attaloslife/ThermoLoop/v1.0/Enclosure/Base.SLDPRT

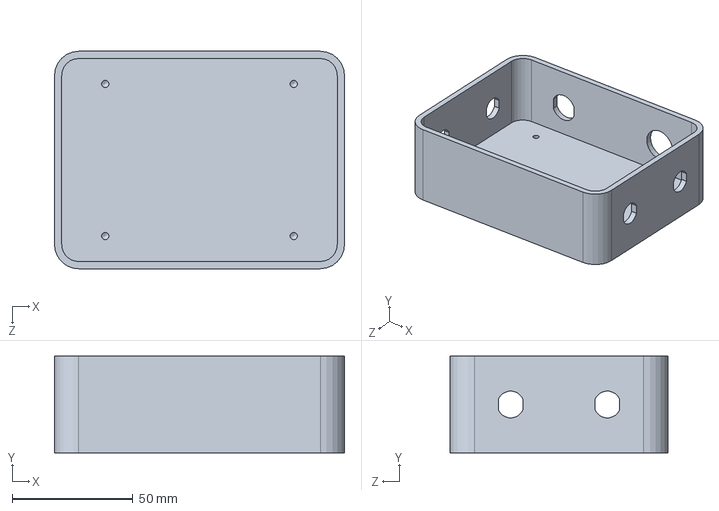
[picture p1: CAD file, 2026-09-18]
v1.0/Enclosure/Base.SLDPRT
120.0 x 40.0 x 90.0 mm
