attaloslife/ThermoLoop/v1.0/Enclosure/Tensility 54-00293 3-Pin Connector.SLDASM

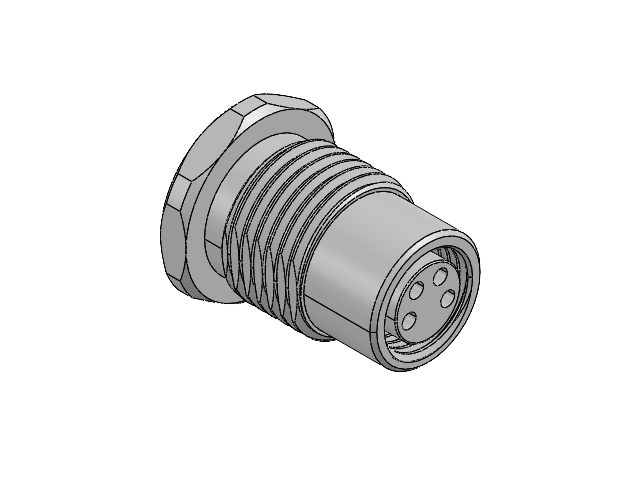
[picture p2: CAD file, 2026-09-18]
v1.0/Enclosure/Tensility 54-00293 3-Pin Connector.SLDASM
54-00293-01___.STEP
54-00293-02___.STEP
54-00293-03___.STEP x 4
54-00293-06___.STEP
