attaloslife/ThermoLoop/v1.0/Simulation/results/pwm.csv

time_s | gpio_V | fan_pwm_V | reset_pwm_V
0.0 | 0.0 | 4.999999999999557 | 4.999999999999556
5e-10 | 0.0 | 4.999999999999556 | 4.999999999999556
1e-09 | 0.0 | 4.999999999999555 | 4.999999999999556
2e-09 | 0.0 | 4.999999999999554 | 4.999999999999556
4e-09 | 0.0 | 4.999999999999554 | 4.999999999999556
8e-09 | 0.0 | 4.999999999999555 | 4.999999999999556
1.6e-08 | 0.0 | 4.999999999999556 | 4.999999999999555
3.2e-08 | 0.0 | 4.999999999999554 | 4.999999999999553
6.4e-08 | 0.0 | 4.999999999999556 | 4.999999999999555
1.1400000000000001e-07 | 0.0 | 4.999999999999555 | 4.999999999999557
1.64e-07 | 0.0 | 4.999999999999554 | 4.999999999999556
2.14e-07 | 0.0 | 4.999999999999553 | 4.999999999999556
2.6400000000000003e-07 | 0.0 | 4.999999999999553 | 4.999999999999556
3.1400000000000003e-07 | 0.0 | 4.999999999999554 | 4.999999999999556
3.6400000000000003e-07 | 0.0 | 4.999999999999555 | 4.999999999999556
4.1400000000000003e-07 | 0.0 | 4.999999999999555 | 4.999999999999556
4.64e-07 | 0.0 | 4.999999999999554 | 4.999999999999556
5.140000000000001e-07 | 0.0 | 4.999999999999553 | 4.999999999999556
5.640000000000001e-07 | 0.0 | 4.999999999999553 | 4.999999999999556
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
