attaloslife/ThermoLoop/v1.0/Simulation/results/startup_0s.csv

time_s | fan_supply_V | source_A
0.0 | 11.975 | 0.05000000000000071
1e-05 | 11.974999999999998 | 0.05000000000000426
2e-05 | 11.974999999999998 | 0.05000000000000426
4e-05 | 11.975000000000001 | 0.04999999999999716
8e-05 | 11.975000000000003 | 0.049999999999993605
0.00016 | 11.975000000000003 | 0.049999999999993605
0.00032 | 11.975000000000001 | 0.04999999999999716
0.00064 | 11.975000000000001 | 0.04999999999999716
0.00128 | 11.975 | 0.05000000000000071
0.00228 | 11.974999999999998 | 0.05000000000000426
0.00328 | 11.975 | 0.05000000000000071
0.00428 | 11.975 | 0.05000000000000071
0.00528 | 11.975 | 0.05000000000000071
0.00628 | 11.975 | 0.05000000000000071
0.00728 | 11.975 | 0.05000000000000071
0.00828 | 11.975 | 0.05000000000000071
0.00928 | 11.975 | 0.05000000000000071
0.010280000000000001 | 11.975 | 0.05000000000000071
0.011280000000000002 | 11.975 | 0.05000000000000071
0.012280000000000003 | 11.975 | 0.05000000000000071
0.013280000000000004 | 11.975 | 0.05000000000000071
0.014280000000000004 | 11.975 | 0.05000000000000071
0.015280000000000005 | 11.975 | 0.05000000000000071
0.016280000000000006 | 11.975 | 0.05000000000000071
0.017280000000000007 | 11.975 | 0.05000000000000071
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
