attaloslife/ThermoLoop/v1.0/Simulation/results/supply_matrix.csv

source_V | lumped_path_ohm | assumed_limit_A | assumed_fan_start_A | assumed_aux_A | fans | stagger_s | peak_demand_A | running_A | peak_bus_V_if_not_limited | steady_bus_V | optimistic_100uF_hold_up_to_10_8V_s | classification
11.4 | 0.1 | 2.0 | 0.55 | 0.05 | 1 | 0 | 0.6000000000000001 | 0.6000000000000001 | 11.34 | 11.34 |  | within_provisional_envelope
11.4 | 0.1 | 2.0 | 0.55 | 0.05 | 1 | 5 | 0.6000000000000001 | 0.6000000000000001 | 11.34 | 11.34 |  | within_provisional_envelope
11.4 | 0.1 | 2.0 | 0.55 | 0.05 | 2 | 0 | 1.1500000000000001 | 1.1500000000000001 | 11.285 | 11.285 |  | within_provisional_envelope
11.4 | 0.1 | 2.0 | 0.55 | 0.05 | 2 | 5 | 1.1500000000000001 | 1.1500000000000001 | 11.285 | 11.285 |  | within_provisional_envelope
11.4 | 0.1 | 2.0 | 0.55 | 0.1 | 1 | 0 | 0.65 | 0.65 | 11.335 | 11.335 |  | within_provisional_envelope
11.4 | 0.1 | 2.0 | 0.55 | 0.1 | 1 | 5 | 0.65 | 0.65 | 11.335 | 11.335 |  | within_provisional_envelope
11.4 | 0.1 | 2.0 | 0.55 | 0.1 | 2 | 0 | 1.2000000000000002 | 1.2000000000000002 | 11.280000000000001 | 11.280000000000001 |  | within_provisional_envelope
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
