attaloslife/ThermoLoop/v1.0/Simulation/results/temperature_accuracy.csv

true_bead_C | modeled_error_min_C | modeled_error_max_C | half_LSB_error_max_C | self_heating_estimate_C | source_impedance_ohm | filter_tau_ms | filter_settle_half_LSB_ms | R25_positive_parameter_error_C | beta_positive_parameter_error_C | pullup_positive_parameter_error_C | ADC_2LSB_positive_parameter_error_C
25 | -0.7686138532935161 | 0.7725972775466516 | 0.05060239693636959 | 0.34031249999999996 | 6000.0 | 0.6 | 4.5741851679069425 | -0.2572796783703666 | 0.0 | 0.25772446970808005 | -0.20223893290693695
26 | -0.8236413026633613 | 0.8284664213385327 | 0.05096229269582864 | 0.3401863415334985 | 5903.730380721314 | 0.5903730380721314 | 4.500792657136174 | -0.2590076635256082 | 0.05017611539750533 | 0.2594569454057023 | -0.20365749627097784
27 | -0.8791698141869801 | 0.8849200807811712 | 0.051361155791994406 | 0.33981159123821086 | 5808.172720443777 | 0.5808172720443776 | 4.4279429184159405 | -0.26074142714259096 | 0.10070457976848957 | 0.261195229687587 | -0.20523146370760514
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
