attaloslife/ThermoLoop/v1.0/Simulation/results/Fan_PWM.cir

.title ThermoLoop Fan_PWM
.include "spice/pwm.inc"
.tran 50n 200u
.end
