attaloslife/ThermoLoop/v1.0/Simulation/results/Startup.cir

.title ThermoLoop Startup
.include "spice/startup.inc"
.tran 1m 7 0 1m
.end
