attaloslife/ThermoLoop/v1.0/Simulation/results/Thermistors.cir

.title ThermoLoop Thermistors
.include "spice/thermistors.inc"
.dc Vtemperature 0 90 1
.end
