attaloslife/ThermoLoop/v1.0/1 Fan 2 Th/_restore_backup_2026-09-18T16-37-54-304/1 Fan 2 Th.kicad_pcb

## KiCad design v1.0/1 Fan 2 Th/_restore_backup_2026-09-18T16-37-54-304/1 Fan 2 Th.kicad_pcb (2026-09-15)

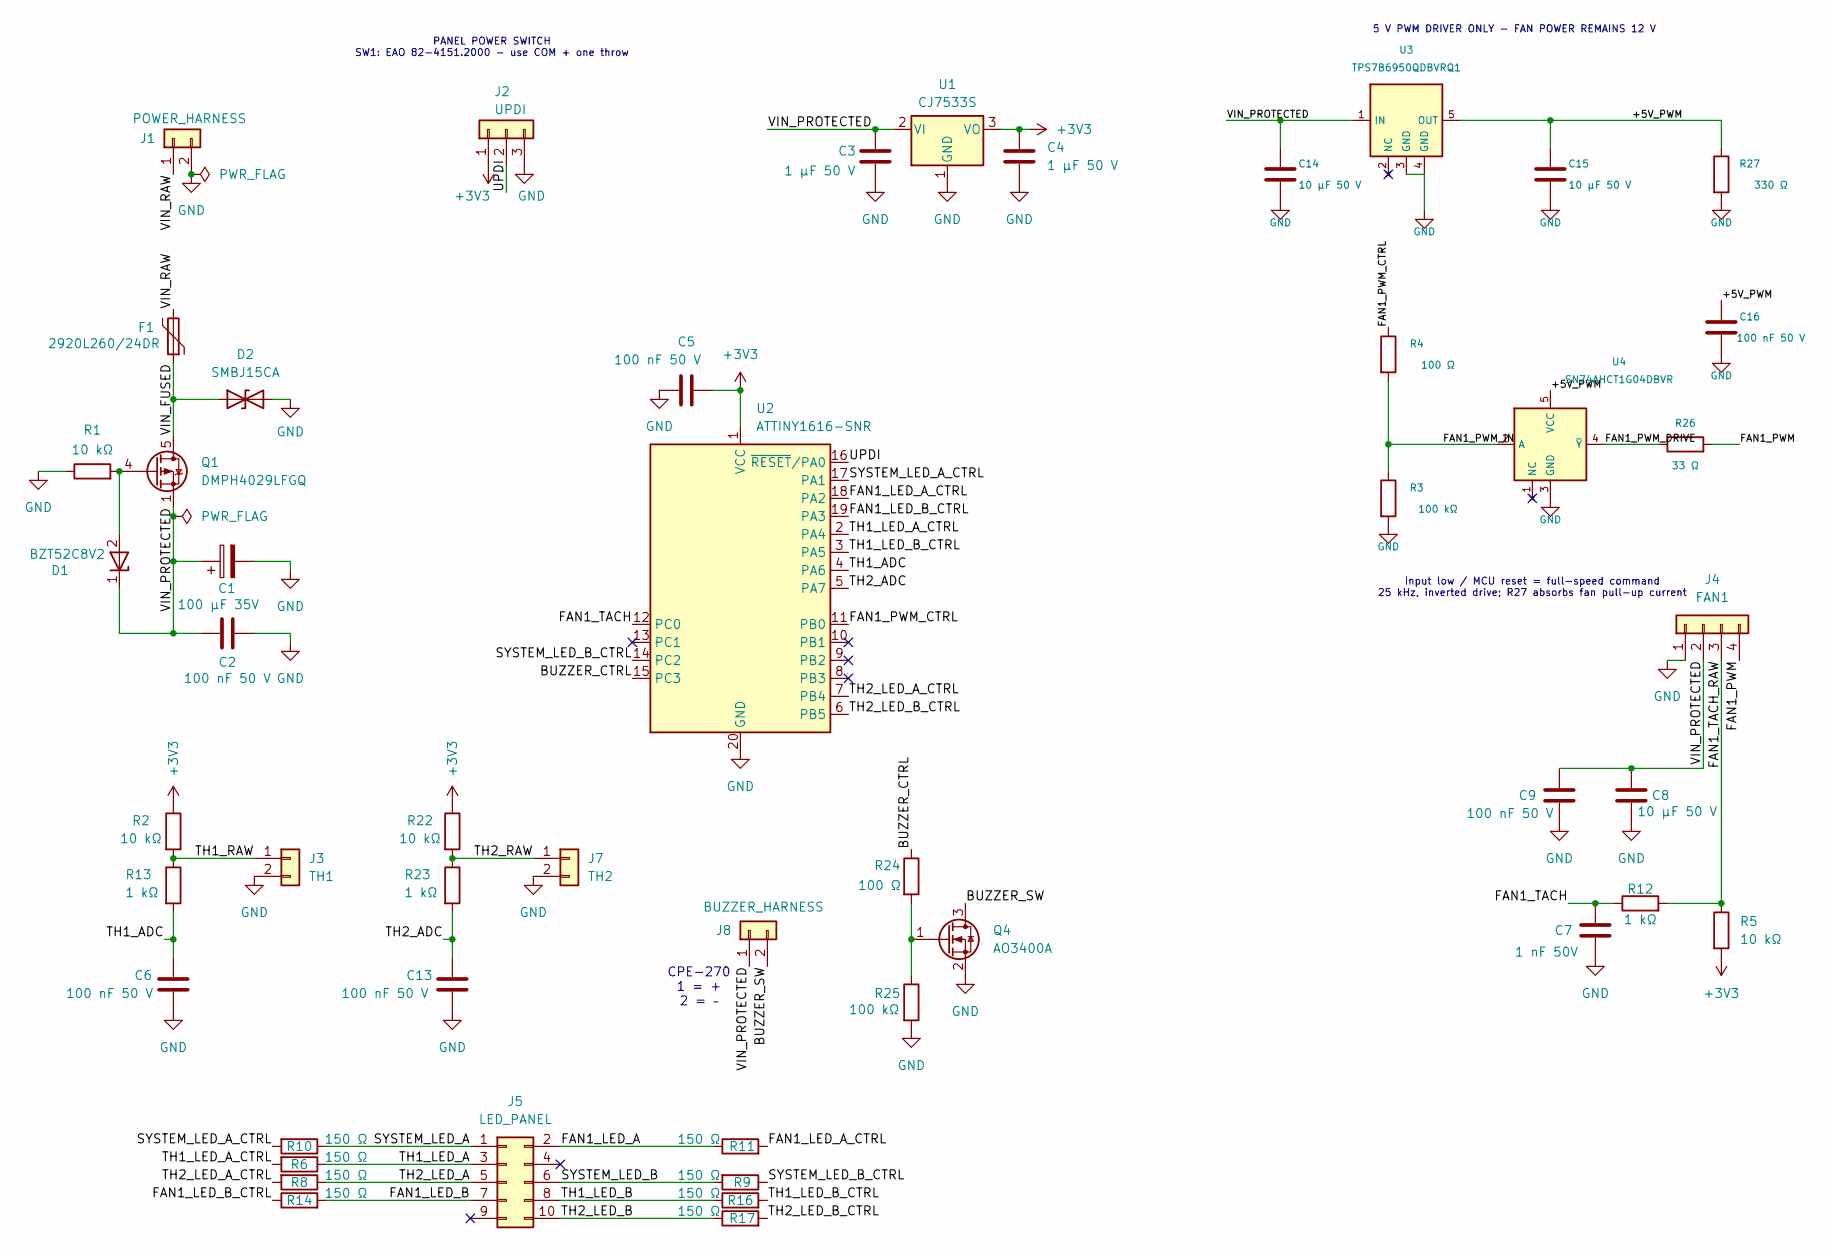
[picture p3: schematic 1 Fan 2 Th.kicad_sch]

Parts:
C1: 100 µF 35V; CP_Elec_6.3x7.7; MPN VZH101M1VTR-0607; JLCPCB C176683
C2, C5, C6, C9, C13, C16: 100 nF 50 V; C_0805_2012Metric; Tolerance ±10%; MPN CC0805KRX7R9BB104; JLCPCB C49678
C3, C4: 1 µF 50 V; C_0805_2012Metric; Tolerance ±10%; MPN CL21B105KBFNNNE; JLCPCB C28323
C7: 1 nF 50V; C_0805_2012Metric; Tolerance ±10%; MPN CL21B102KBCNNNC; JLCPCB C46653
C8, C14, C15: 10 µF 50 V; C_1210_3225Metric; MPN CL32B106KBJNNNE; JLCPCB C138687
D1: BZT52C8V2; D_SOD-123; MPN BZT52C8V2; JLCPCB C173432
D2: SMBJ15CA; D_SMB; MPN SMBJ15CA; JLCPCB C78809
F1: 2920L260/24DR; Fuse_2920_7451Metric; MPN 2920L260/24DR; JLCPCB C315904
J1: POWER_HARNESS; Molex_Micro-Fit_3.0_43045-0218_2x01-1MP_P3.00mm_Vertical; MPN 43045-0218; JLCPCB C476811
J2: UPDI; PinHeader_1x03_P2.54mm_Vertical; MPN 2.54-1*3PPin; JLCPCB C49257
J3: TH1; Molex_Micro-Fit_3.0_43045-0218_2x01-1MP_P3.00mm_Vertical; MPN 43045-0218; JLCPCB C476811
J4: FAN1; Molex_Micro-Fit_3.0_43045-0418_2x02-1MP_P3.00mm_Vertical; MPN 43045-0418; JLCPCB C293535
J5: LED_PANEL; Molex_Micro-Fit_3.0_43045-1018_2x05-1MP_P3.00mm_Vertical; MPN 43045-1018; JLCPCB C476814
J7: TH2; Molex_Micro-Fit_3.0_43045-0218_2x01-1MP_P3.00mm_Vertical; MPN 43045-0218; JLCPCB C476811
J8: BUZZER_HARNESS; Molex_Micro-Fit_3.0_43045-0218_2x01-1MP_P3.00mm_Vertical; MPN 43045-0218; JLCPCB C476811
Q1: DMPH4029LFGQ; Diodes_PowerDI3333-8; MPN DMPH4029LFGQ-7; JLCPCB C3279395
Q4: AO3400A; SOT-23; MPN AO3400A; JLCPCB C20917
R1, R2, R5, R22: 10 kΩ; R_0603_1608Metric; Tolerance ±1%; MPN 0603WAF1002T5E; JLCPCB C25804
R3, R25: 100 kΩ; R_0603_1608Metric; Tolerance ±1%; MPN 0603WAF1003T5E; JLCPCB C25803
R4, R24: 100 Ω; R_0603_1608Metric; Tolerance ±1%; MPN 0603WAF1000T5E; JLCPCB C22775
R6, R8, R9, R10, R11, R14, R16, R17: 150 Ω; R_0603_1608Metric; Tolerance ±1%; MPN 0603WAF1500T5E; JLCPCB C22808
R12, R13, R23: 1 kΩ; R_0603_1608Metric; Tolerance ±1%; MPN 0603WAF1001T5E; JLCPCB C21190
R26: 33 Ω; R_0603_1608Metric; Tolerance ±1%; MPN 0603WAF330JT5E; JLCPCB C23140
R27: 330 Ω; R_0805_2012Metric; Tolerance ±1%; MPN 0805W8F3300T5E; JLCPCB C17630
U1: CJ7533S; SOT-89-3; MPN CJ7533S; JLCPCB C2829417
U2: ATTINY1616-SNR; SOIC-20W_7.5x12.8mm_P1.27mm; MPN ATTINY1616-SNR; JLCPCB C609652
U3: TPS7B6950QDBVRQ1; SOT-23-5; MPN TPS7B6950QDBVRQ1; JLCPCB C132202
U4: SN74AHCT1G04DBVR; SOT-23-5; MPN SN74AHCT1G04DBVR; JLCPCB C30326

Connections:
+3V3: C4.1, C5.1, J2.1, R2.1, R5.2, R22.1, U1.3 (VO), U2.1 (VCC)
/+5V_PWM: C15.1, C16.1, R27.1, U3.5 (OUT), U4.5 (VCC)
/BUZZER_CTRL: R24.1, U2.15 (PC3)
/BUZZER_SW: J8.2, Q4.3 (D)
/FAN1_LED_A: J5.2, R11.1
/FAN1_LED_A_CTRL: R11.2, U2.18 (PA2)
/FAN1_LED_B: J5.7, R14.2
/FAN1_LED_B_CTRL: R14.1, U2.19 (PA3)
/FAN1_PWM: J4.4, R26.2
/FAN1_PWM_CTRL: R4.1, U2.11 (PB0)
/FAN1_PWM_DRIVE: R26.1, U4.4 (~Y)
/FAN1_PWM_IN: R3.1, R4.2, U4.2 (A)
/FAN1_TACH: C7.1, R12.1, U2.12 (PC0)
/FAN1_TACH_RAW: J4.3, R5.1, R12.2
/SYSTEM_LED_A: J5.1, R10.1
/SYSTEM_LED_A_CTRL: R10.2, U2.17 (PA1)
/SYSTEM_LED_B: J5.6, R9.2
/SYSTEM_LED_B_CTRL: R9.1, U2.14 (PC2)
/TH1_ADC: C6.1, R13.2, U2.4 (PA6)
/TH1_LED_A: J5.3, R6.1
/TH1_LED_A_CTRL: R6.2, U2.2 (PA4)
/TH1_LED_B: J5.8, R16.1
/TH1_LED_B_CTRL: R16.2, U2.3 (PA5)
/TH1_RAW: J3.1, R2.2, R13.1
/TH2_ADC: C13.1, R23.2, U2.5 (PA7)
/TH2_LED_A: J5.5, R8.1
/TH2_LED_A_CTRL: R8.2, U2.7 (PB4)
/TH2_LED_B: J5.10, R17.1
/TH2_LED_B_CTRL: R17.2, U2.6 (PB5)
/TH2_RAW: J7.1, R22.2, R23.1
/UPDI: J2.2, U2.16 (~RESET/PA0)
/VIN_FUSED: D2.1 (A1), F1.1, Q1.5 (D)
/VIN_PROTECTED: C1.1, C2.1, C3.1, C8.1, C9.1, C14.1, D1.1 (K), J4.2, J8.1, Q1.1 (S), Q1.2 (S), Q1.3 (S), U1.2 (VI), U3.1 (IN)
/VIN_RAW: F1.2, J1.1
GND: C1.2, C2.2, C3.2, C4.2, C5.2, C6.2, C7.2, C8.2, C9.2, C13.2, C14.2, C15.2, C16.2, D2.2 (A2), J1.2, J2.3, J3.2, J4.1, J7.2, Q4.2 (S), R1.1, R3.2, R25.2, R27.2, U1.1 (GND), U2.20 (GND), U3.3 (GND), U3.4 (GND), U4.3 (GND)
unnamed: D1.2 (A), Q1.4 (G), R1.2
unnamed: Q4.1 (G), R24.2, R25.1

Notes on the sheet:
PANEL POWER SWITCH SW1: EAO 82-4151.2000 - use COM + one throw
CPE-270 1 = + 2 = –
5 V PWM DRIVER ONLY - FAN POWER REMAINS 12 V
Input low / MCU reset = full-speed command 25 kHz, inverted drive; R27 absorbs fan pull-up current

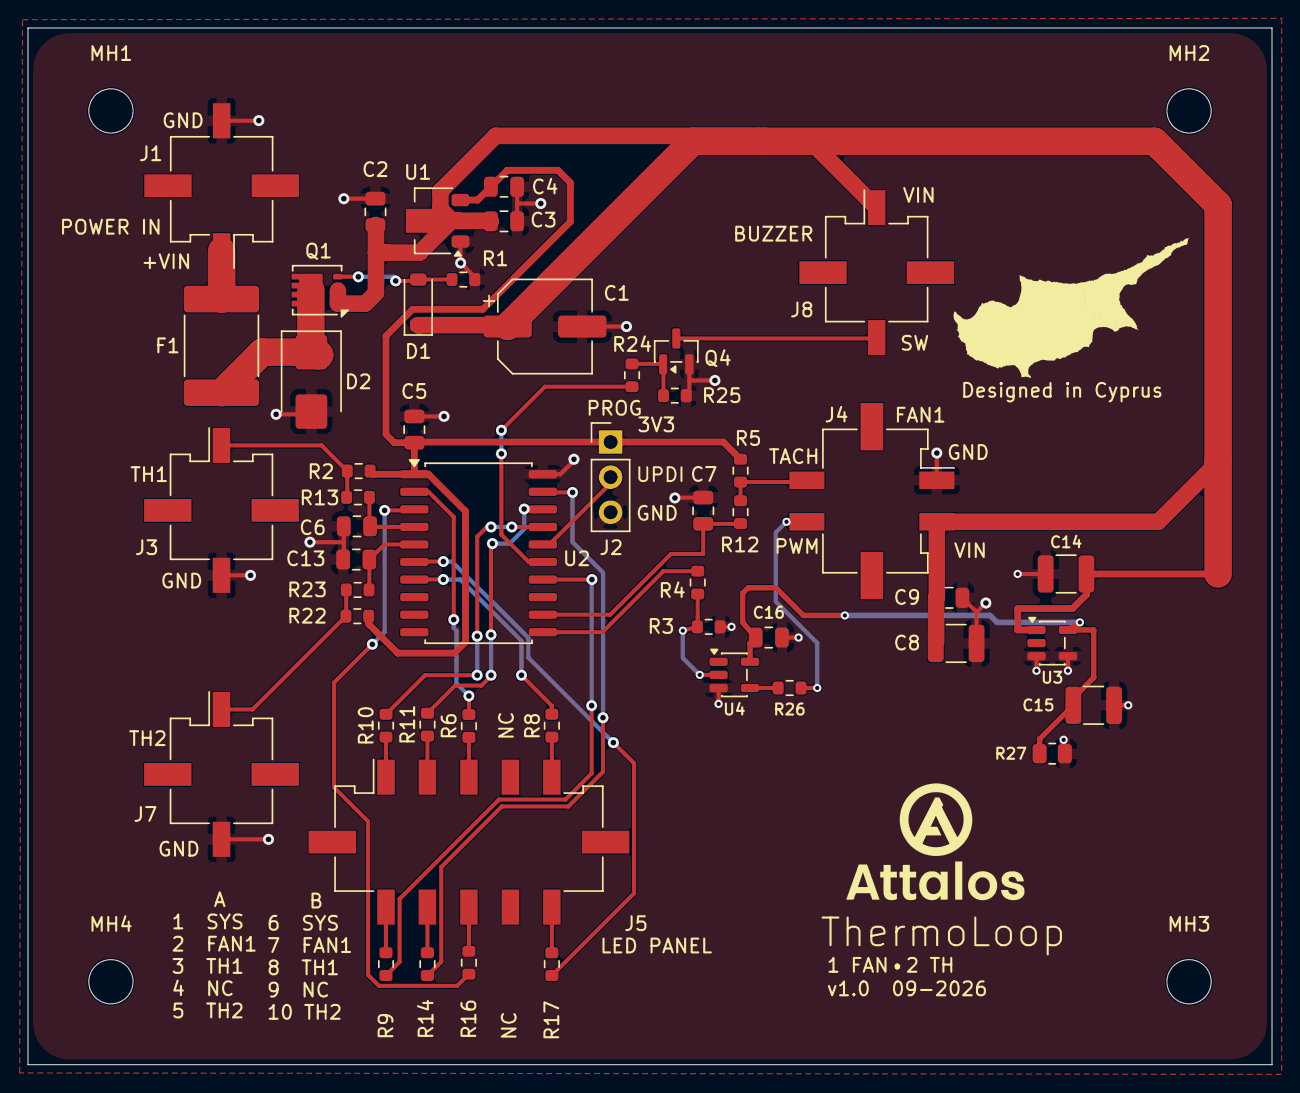
[picture p4: board 1 Fan 2 Th.kicad_pcb from above]

Board: 2 copper layers, 90.0 x 75.0 mm, 54 parts (0 on the bottom side), 37 nets.

Other parts of the board:
MH1, MH2, MH3, MH4: MountingHole_3.2mm_M3
