attaloslife/ThermoLoop/v0.3/5V/1 Fan/5V_1Fan/5V_1Fan.kicad_pcb

## KiCad design v0.3/5V/1 Fan/5V_1Fan/5V_1Fan.kicad_pcb (2026-08-31, an earlier design)

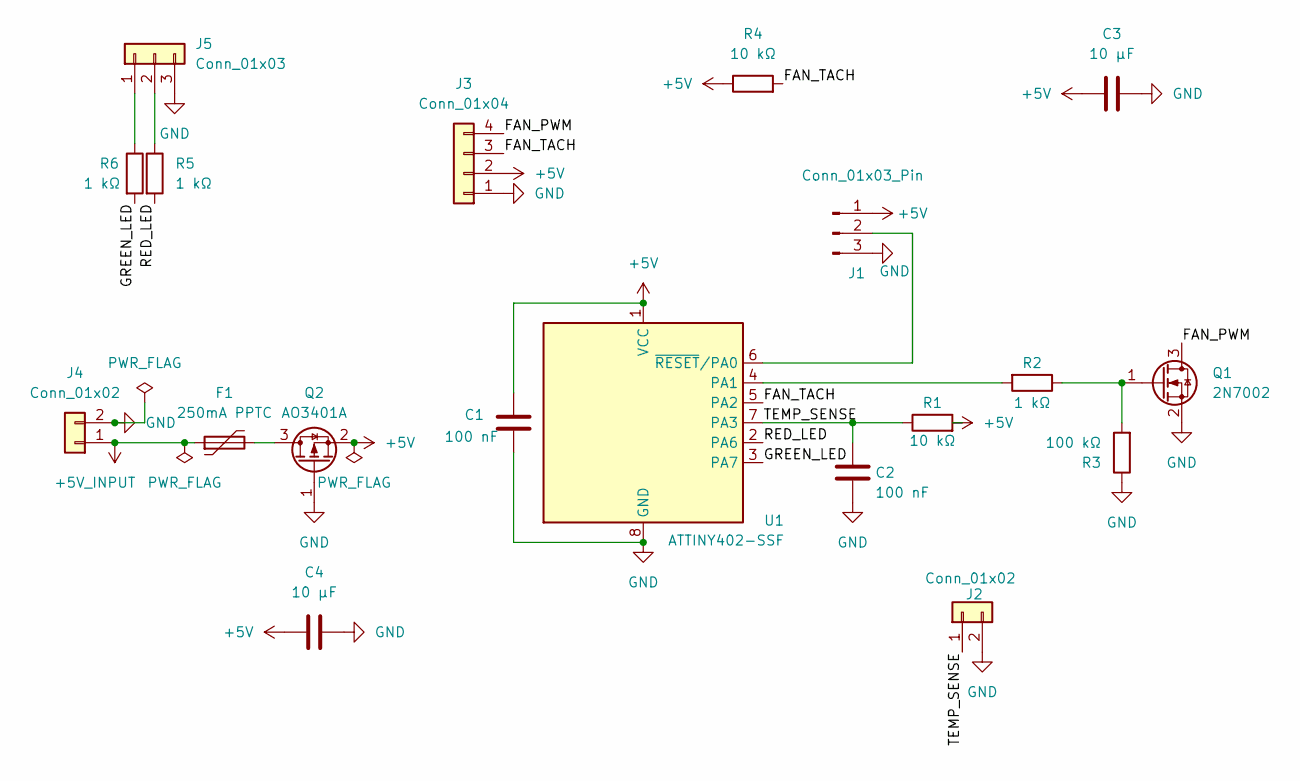
[picture p5: schematic 5V_1Fan.kicad_sch]

Parts:
C1, C2: 100 nF; C_0805_2012Metric_Pad1.18x1.45mm_HandSolder; MPN GRM21BR71H104KA01L; JLCPCB Part C77082
C3, C4: 10 µF; C_1206_3216Metric_Pad1.33x1.80mm_HandSolder; MPN TCC1206X7R106K160HT; JLCPCB Part C380363
F1: 250mA PPTC; Fuse_1206_3216Metric_Pad1.42x1.75mm_HandSolder; MPN 1206L025/24YR; JLCPCB Part C3762322
J1: Conn_01x03_Pin; PinHeader_1x03_P2.54mm_Vertical; MPN 2.54-1*3; JLCPCB Part C5116482
J2: Conn_01x02; JST_PH_B2B-PH-K_1x02_P2.00mm_Vertical; MPN B2B-PH-K-S; JLCPCB Part C20504437
J3: Conn_01x04; FanPinHeader_1x04_P2.54mm_Vertical; MPN 470531000; JLCPCB Part C240840
J4: Conn_01x02; JST_XH_B2B-XH-A_1x02_P2.50mm_Vertical; MPN B2B-XH-A(LF)(SN); JLCPCB Part C158012
J5: Conn_01x03; JST_PH_B3B-PH-K_1x03_P2.00mm_Vertical; MPN B3B-PH-K-S(LF)(SN); JLCPCB Part C131339
Q1: 2N7002; SOT-23; MPN 2N7002; JLCPCB Part C389059
Q2: AO3401A; SOT-23; MPN AO3401A; JLCPCB Part C15127
R1, R4: 10 kΩ; R_0805_2012Metric_Pad1.20x1.40mm_HandSolder; MPN RC0805FR-0710KL; JLCPCB Part C84376
R2, R5, R6: 1 kΩ; R_0805_2012Metric_Pad1.20x1.40mm_HandSolder; MPN RC0805FR-071KL; JLCPCB Part C95781
R3: 100 kΩ; R_0805_2012Metric_Pad1.20x1.40mm_HandSolder; MPN RC0805FR-07100KL; JLCPCB Part C96346
U1: ATTINY402-SSF; SOIC-8_3.9x4.9mm_P1.27mm; MPN ATTINY402-SSF; JLCPCB Part C1338236

Connections:
+5V: C1.1, C3.2, C4.1, J1.1, J3.2, Q2.2 (S), R1.2, R4.1, U1.1 (VCC)
+5V_INPUT: F1.1, J4.1
/FAN_PWM: J3.4, Q1.3 (D)
/FAN_TACH: J3.3, R4.2, U1.5 (PA2)
/GREEN_LED: R6.2, U1.3 (PA7)
/RED_LED: R5.2, U1.2 (PA6)
/TEMP_SENSE: C2.1, J2.1, R1.1, U1.7 (PA3)
GND: C1.2, C2.2, C3.1, C4.2, J1.3, J2.2, J3.1, J4.2, J5.3, Q1.2 (S), Q2.1 (G), R3.1, U1.8 (GND)
unnamed: J1.2, U1.6 (~RESET/PA0)
unnamed: J5.1, R6.1
unnamed: J5.2, R5.1
unnamed: Q1.1 (G), R2.1, R3.2
unnamed: F1.2, Q2.3 (D)
unnamed: R2.2, U1.4 (PA1)

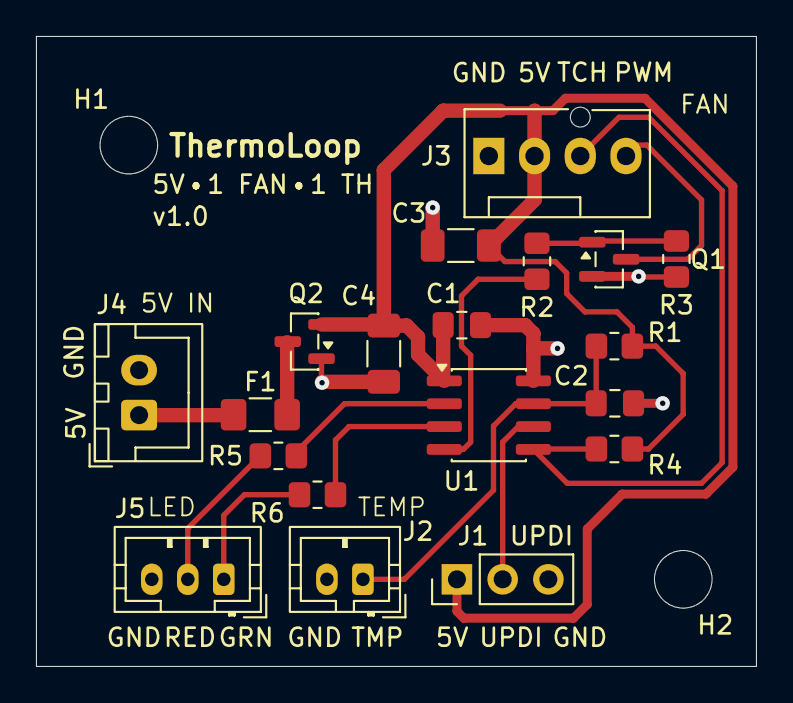
[picture p6: board 5V_1Fan.kicad_pcb from above]

Board: 2 copper layers, 40.0 x 35.0 mm, 21 parts (0 on the bottom side), 14 nets.

Other parts of the board:
H1, H2: MountingHole_3.2mm_M3_DIN965
