attaloslife/ThermoLoop/v0.2/hardware/KiCad/Dual_PWM_Fan_Controller/_restore_backup_2026-08-24T08-54-07-312/Dual_PWM_Fan_Controller.kicad_pcb

## KiCad design v0.2/hardware/KiCad/Dual_PWM_Fan_Controller/_restore_backup_2026-08-24T08-54-07-312/Dual_PWM_Fan_Controller.kicad_pcb (2026-08-25, an earlier design)

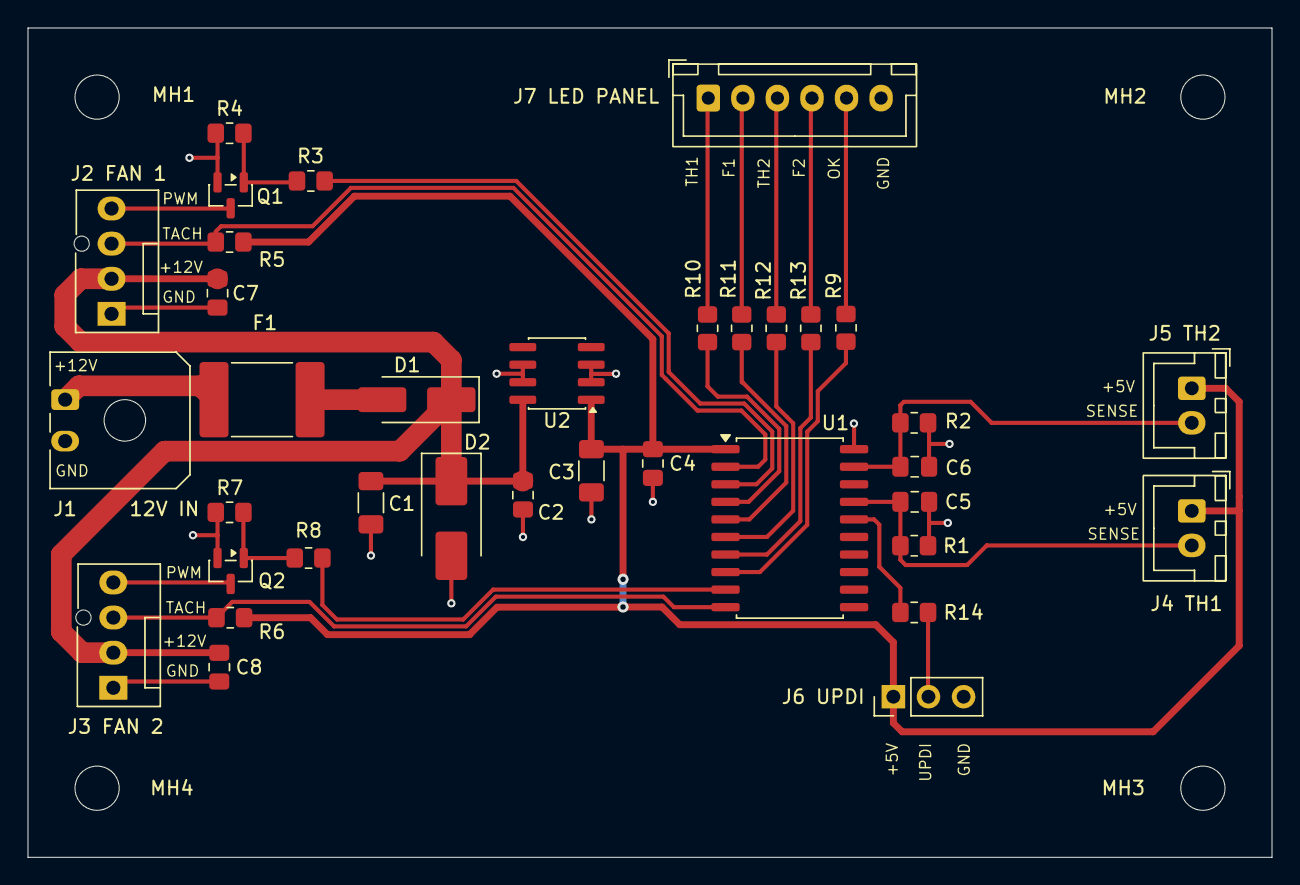
[picture p7: board Dual_PWM_Fan_Controller.kicad_pcb from above]

Board: 2 copper layers, 90.0 x 60.0 mm, 40 parts (0 on the bottom side), 27 nets.

Parts:
C1: 10uF 25V; C_1206_3216Metric_Pad1.33x1.80mm_HandSolder
C2, C4, C5, C6, C7, C8: 100nF; C_0805_2012Metric_Pad1.18x1.45mm_HandSolder
C3: 10uF 16V; C_1206_3216Metric_Pad1.33x1.80mm_HandSolder
D1: SS34; D_SMA_Handsoldering
D2: SMBJ15A; D_SMB_Handsoldering
F1: 3A; Fuse_2920_7451Metric_Pad2.10x5.45mm_HandSolder
J1     12V IN: Conn_01x02; Molex_Micro-Fit_3.0_43650-0200_1x02_P3.00mm_Horizontal
J2 FAN 1, J3 FAN 2: Conn_01x04; FanPinHeader_1x04_P2.54mm_Vertical
J4 TH1, J5 TH2: Conn_01x02; JST_XH_B2B-XH-A_1x02_P2.50mm_Vertical
J6 UPDI: Conn_01x03; PinHeader_1x03_P2.54mm_Vertical
J7 LED PANEL: LED Panel; JST_XH_B6B-XH-A_1x06_P2.50mm_Vertical
MH1, MH2, MH3, MH4: MountingHole_3.2mm_M3
Q1, Q2: 2N7002; SOT-23
R1, R2: 10k 1%; R_0805_2012Metric_Pad1.20x1.40mm_HandSolder
R3, R8: 100Ω; R_0805_2012Metric_Pad1.20x1.40mm_HandSolder
R4, R7: 100kΩ; R_0805_2012Metric_Pad1.20x1.40mm_HandSolder
R5, R6: 10kΩ; R_0805_2012Metric_Pad1.20x1.40mm_HandSolder
R9, R10, R11, R12, R13: 1kΩ; R_0805_2012Metric_Pad1.20x1.40mm_HandSolder
R14: 470Ω; R_0805_2012Metric_Pad1.20x1.40mm_HandSolder
U1: ATtiny1616-S; SOIC-20W_7.5x12.8mm_P1.27mm
U2: L78L05_SO8; SOIC-8_3.9x4.9mm_P1.27mm

Connections:
+5V: C3.1, C4.2, J4 TH1.1, J5 TH2.1, J6 UPDI.1, R5.1, R6.2, U1.1 (VCC), U2.1 (OUT)
/+12V_FUSED: D1.2 (A), F1.2
/+12V_IN: F1.1, J1 12V IN.1
/+12V_PROTECTED: C1.2, C2.1, C7.2, C8.1, D1.1 (K), D2.1 (A1), J2 FAN 1.2, J3 FAN 2.2, U2.8 (IN)
/FAN1_PWM: J2 FAN 1.4, Q1.3 (D)
/FAN1_TACH: J2 FAN 1.3, R5.2, U1.2 (PA4)
/FAN2_PWM: J3 FAN 2.4, Q2.3 (D)
/FAN2_TACH: J3 FAN 2.3, R6.1, U1.10 (PB1)
/LED_FAN1_FAULT: J7 LED PANEL.2, R11.2
/LED_FAN2_FAULT: J7 LED PANEL.4, R13.2
/LED_OK: J7 LED PANEL.5, R9.2
/LED_TH1_FAULT: J7 LED PANEL.1, R10.1
/TH1_SENSE: C5.1, J4 TH1.2, R1.1, U1.17 (PA1)
/TH2_FAULT: J7 LED PANEL.3, R12.2
/TH2_SENSE: C6.1, J5 TH2.2, R2.1, U1.19 (PA3)
/UPDI: R14.2, U1.16 (~RESET/PA0)
GND: C1.1, C2.2, C3.2, C4.1, C5.2, C6.2, C7.1, C8.2, D2.2 (A2), J1 12V IN.2, J2 FAN 1.1, J3 FAN 2.1, J6 UPDI.3, J7 LED PANEL.6, Q1.2 (S), Q2.2 (S), R1.2, R2.2, R4.2, R7.2, U1.20 (GND), U2.2 (GND), U2.3 (GND), U2.6 (GND), U2.7 (GND)
unnamed: J6 UPDI.2, R14.1
unnamed: Q1.1 (G), R3.1, R4.1
unnamed: Q2.1 (G), R7.1, R8.2
unnamed: R3.2, U1.3 (PA5)
unnamed: R10.2, U1.4 (PA6)
unnamed: R11.1, U1.5 (PA7)
unnamed: R8.1, U1.9 (PB2)
unnamed: R9.1, U1.8 (PB3)
unnamed: R13.1, U1.7 (PB4)
unnamed: R12.1, U1.6 (PB5)
