attaloslife/ThermoLoop/v1.0/1 Fan 1TH/1 Fan 1 TH/1 Fan 1 TH.kicad_sch

## KiCad design v1.0/1 Fan 1TH/1 Fan 1 TH/1 Fan 1 TH.kicad_sch (2026-09-01)

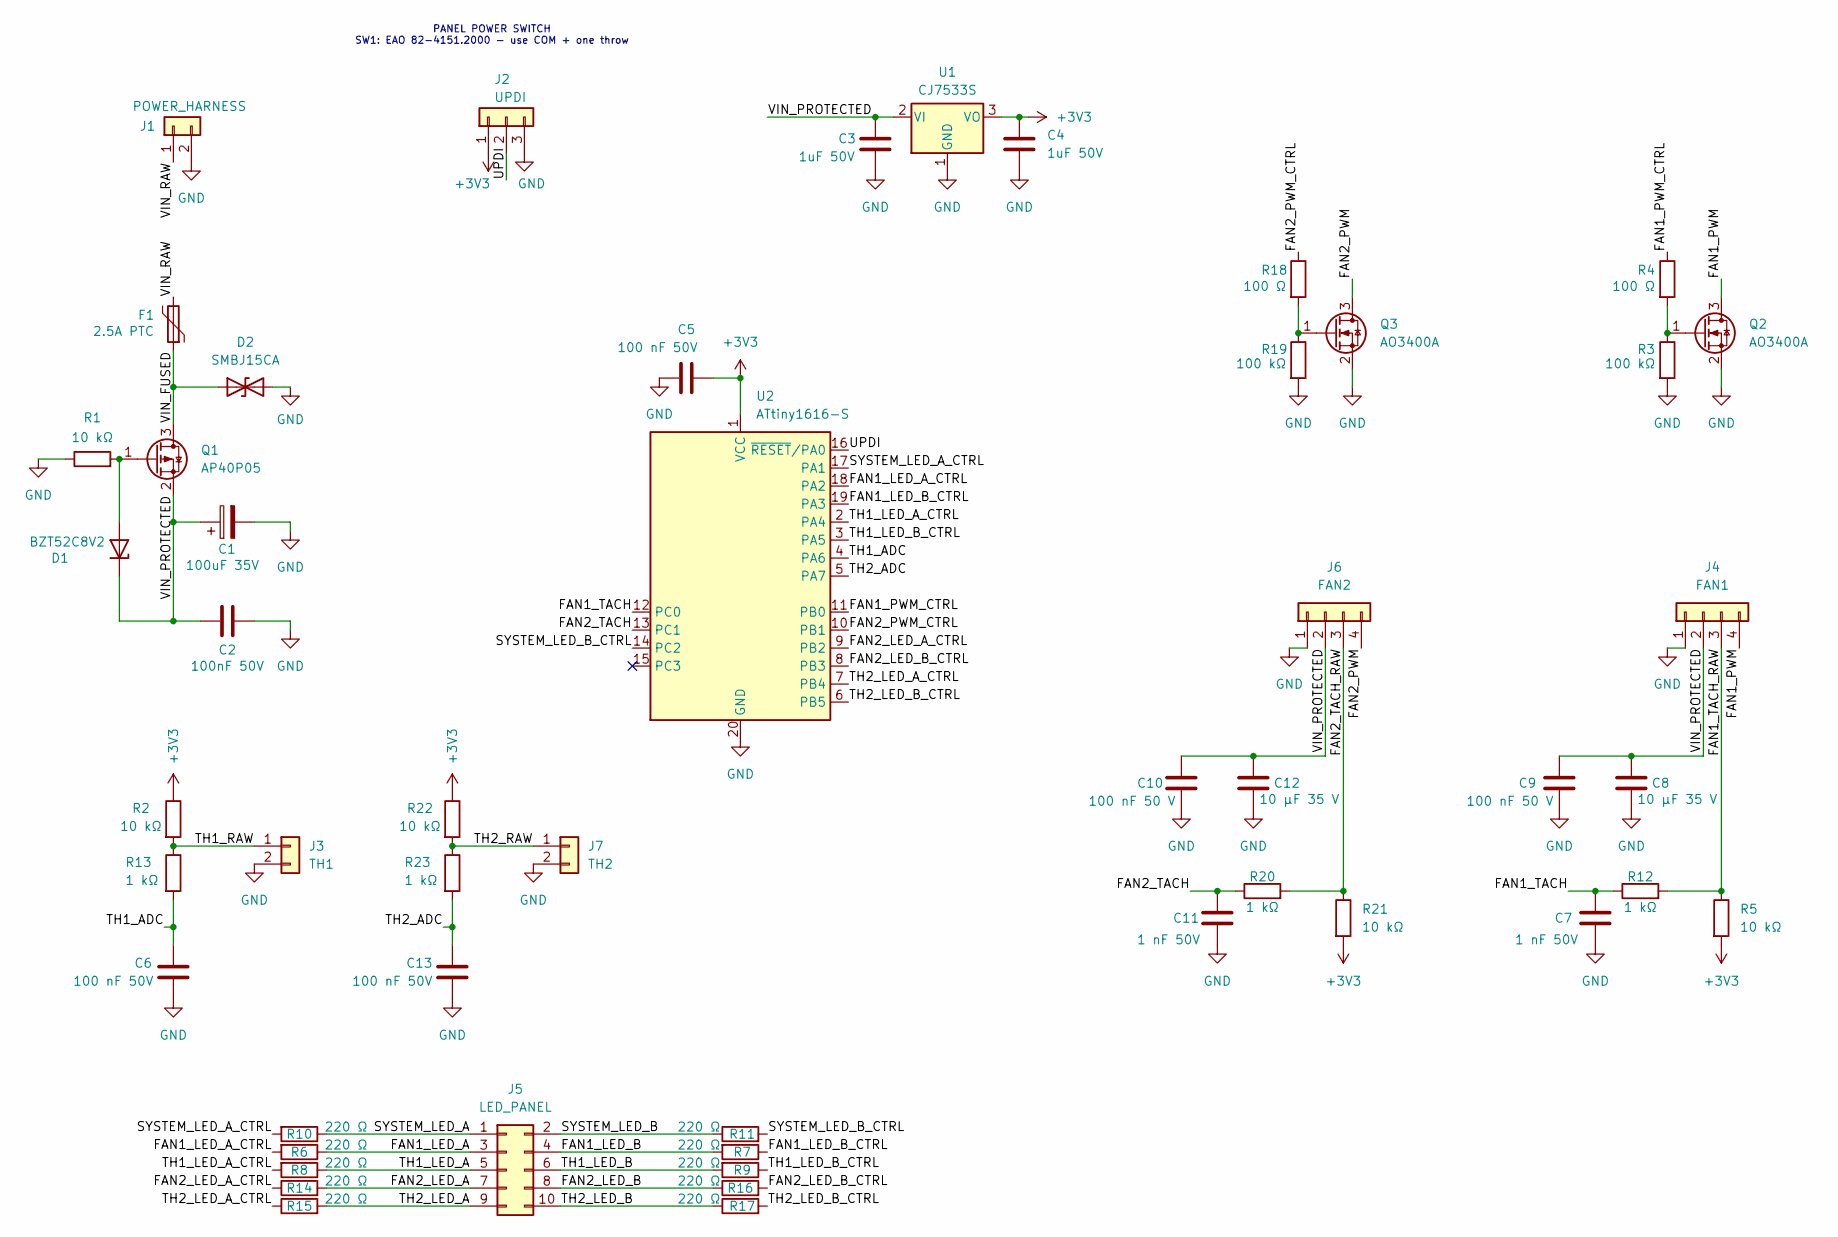
[picture p8: schematic 1 Fan 1 TH.kicad_sch]

Parts:
C1: 100uF 35V
C2: 100nF 50V
C3, C4: 1uF 50V
C5, C6, C13: 100 nF 50V
C7, C11: 1 nF 50V
C8, C12: 10 µF 35 V
C9, C10: 100 nF 50 V
D1: BZT52C8V2
D2: SMBJ15CA
F1: 2.5A PTC
J1: POWER_HARNESS
J2: UPDI
J3: TH1
J4: FAN1
J5: LED_PANEL
J6: FAN2
J7: TH2
Q1: AP40P05
Q2, Q3: AO3400A; SOT-23
R1, R2, R5, R21, R22: 10 kΩ
R3, R19: 100 kΩ
R4, R18: 100 Ω
R6, R7, R8, R9, R10, R11, R14, R15, R16, R17: 220 Ω
R12, R13, R20, R23: 1 kΩ
U1: CJ7533S; SOT-89-3
U2: ATtiny1616-S; SOIC-20W_7.5x12.8mm_P1.27mm

Connections:
+3V3: C4.1, C5.1, J2.1, R2.1, R5.2, R21.2, R22.1, U1.3 (VO), U2.1 (VCC)
FAN1_LED_A: J5.3, R6.1
FAN1_LED_A_CTRL: R6.2, U2.18 (PA2)
FAN1_LED_B: J5.4, R7.2
FAN1_LED_B_CTRL: R7.1, U2.19 (PA3)
FAN1_PWM: J4.4, Q2.3 (D)
FAN1_PWM_CTRL: R4.1, U2.11 (PB0)
FAN1_TACH: C7.1, R12.1, U2.12 (PC0)
FAN1_TACH_RAW: J4.3, R5.1, R12.2
FAN2_LED_A: J5.7, R14.2
FAN2_LED_A_CTRL: R14.1, U2.9 (PB2)
FAN2_LED_B: J5.8, R16.1
FAN2_LED_B_CTRL: R16.2, U2.8 (PB3)
FAN2_PWM: J6.4, Q3.3 (D)
FAN2_PWM_CTRL: R18.1, U2.10 (PB1)
FAN2_TACH: C11.1, R20.1, U2.13 (PC1)
FAN2_TACH_RAW: J6.3, R20.2, R21.1
GND: C1.2, C2.2, C3.2, C4.2, C5.2, C6.2, C7.2, C8.2, C9.2, C10.2, C11.2, C12.2, C13.2, D2.2 (A2), J1.2, J2.3, J3.2, J4.1, J6.1, J7.2, Q2.2 (S), Q3.2 (S), R1.1, R3.2, R19.2, U1.1 (GND), U2.20 (GND)
unnamed: D1.2 (A), Q1.1 (G), R1.2
unnamed: Q2.1 (G), R3.1, R4.2
unnamed: Q3.1 (G), R18.2, R19.1
SYSTEM_LED_A: J5.1, R10.1
SYSTEM_LED_A_CTRL: R10.2, U2.17 (PA1)
SYSTEM_LED_B: J5.2, R11.1
SYSTEM_LED_B_CTRL: R11.2, U2.14 (PC2)
TH1_ADC: C6.1, R13.2, U2.4 (PA6)
TH1_LED_A: J5.5, R8.1
TH1_LED_A_CTRL: R8.2, U2.2 (PA4)
TH1_LED_B: J5.6, R9.2
TH1_LED_B_CTRL: R9.1, U2.3 (PA5)
TH1_RAW: J3.1, R2.2, R13.1
TH2_ADC: C13.1, R23.2, U2.5 (PA7)
TH2_LED_A: J5.9, R15.2
TH2_LED_A_CTRL: R15.1, U2.7 (PB4)
TH2_LED_B: J5.10, R17.1
TH2_LED_B_CTRL: R17.2, U2.6 (PB5)
TH2_RAW: J7.1, R22.2, R23.1
UPDI: J2.2, U2.16 (~RESET/PA0)
VIN_FUSED: D2.1 (A1), F1.1, Q1.3 (D)
VIN_PROTECTED: C1.1, C2.1, C3.1, C8.1, C9.1, C10.1, C12.1, D1.1 (K), J4.2, J6.2, Q1.2 (S), U1.2 (VI)
VIN_RAW: F1.2, J1.1

Notes on the sheet:
PANEL POWER SWITCH SW1: EAO 82-4151.2000 - use COM + one throw
