attaloslife/ThermoLoop/(commit log)

2026-08-19 initial files upload
    [Dual_PWM_Fan_Controller.kicad_pcb, Dual_PWM_Fan_Controller.kicad_sch]
2026-08-19 Assign component footprints
    [Dual_PWM_Fan_Controller.kicad_sch]
2026-08-20 pcb updated
    [Dual_PWM_Fan_Controller.kicad_pcb, Dual_PWM_Fan_Controller.kicad_sch]
2026-08-20 end of v0.1
    [Dual_PWM_Fan_Controller.kicad_pcb]
2026-08-25 sim files
    [Dual_PWM_Fan_Controller-B_Cu.gbl, Dual_PWM_Fan_Controller-B_Mask.gbs, Dual_PWM_Fan_Controller-Edge_Cuts.gm1, Dual_PWM_Fan_Controller-F_Cu.gtl, Dual_PWM_Fan_Controller-F_Mask.gts, Dual_PWM_Fan_Controller-F_Silkscreen.gto, Dual_PWM_Fan_Controller-NPTH.drl, Dual_PWM_Fan_Controller-PTH.drl]
2026-08-25 initial design files
    [5V_1Fan.kicad_pcb, 5V_1Fan.kicad_sch]
2026-08-26 5v 1fan 1th
    [5V_1Fan-B_Cu.gbl, 5V_1Fan-B_Mask.gbs, 5V_1Fan-B_Silkscreen.gbo, 5V_1Fan-Edge_Cuts.gm1, 5V_1Fan-F_Cu.gtl, 5V_1Fan-F_Mask.gts, 5V_1Fan-F_Silkscreen.gto, 5V_1Fan-NPTH.drl]
2026-08-31 updated files
    [5V_1Fan-B_Cu.gbl, 5V_1Fan-B_Mask.gbs, 5V_1Fan-B_Silkscreen.gbo, 5V_1Fan-Edge_Cuts.gm1, 5V_1Fan-F_Cu.gtl, 5V_1Fan-F_Mask.gts, 5V_1Fan-F_Silkscreen.gto, 5V_1Fan-NPTH.drl]
2026-08-31 folder naming changed
    [5V_1Fan-B_Cu.gbl, 5V_1Fan-B_Mask.gbs, 5V_1Fan-B_Silkscreen.gbo, 5V_1Fan-Edge_Cuts.gm1, 5V_1Fan-F_Cu.gtl, 5V_1Fan-F_Mask.gts, 5V_1Fan-F_Silkscreen.gto, 5V_1Fan-NPTH.drl]
2026-09-01 design updated
    [1 Fan 1 TH.kicad_pcb, 1 Fan 1 TH.kicad_sch]
2026-09-01 Update 1 Fan 1 TH.kicad_sch
    mosfet and mistake on th2 naming fixed
    [1 Fan 1 TH.kicad_sch]
2026-09-02 update
    - pcb design started
    -
    [1 Fan 1 TH.kicad_pcb, 2 Fan 2 Th.kicad_pcb, 2 Fan 2 Th.kicad_sch]
2026-09-03 design update
    - silkscreen edited
    - mosfet changed
    - connectors type changed
    - fuse changed
    [2 Fan 2 Th.kicad_pcb, 2 Fan 2 Th.kicad_sch]
2026-09-07 F2Th2 Finalized
    F2Th2 finalized
    [2 Fan 2 Th-B_Cu.gbl, 2 Fan 2 Th-B_Mask.gbs, 2 Fan 2 Th-B_Silkscreen.gbo, 2 Fan 2 Th-Edge_Cuts.gm1, 2 Fan 2 Th-F_Cu.gtl, 2 Fan 2 Th-F_Mask.gts, 2 Fan 2 Th-F_Silkscreen.gto, 2 Fan 2 Th-NPTH.drl]
2026-09-07 1 Fan 2Th version files
    [1 Fan 2 Th-B_Cu.gbl, 1 Fan 2 Th-B_Mask.gbs, 1 Fan 2 Th-B_Silkscreen.gbo, 1 Fan 2 Th-Edge_Cuts.gm1, 1 Fan 2 Th-F_Cu.gtl, 1 Fan 2 Th-F_Mask.gts, 1 Fan 2 Th-F_Silkscreen.gto, 1 Fan 2 Th-NPTH.drl]
2026-09-08 added 5v rail
    added 5v rail for pwm concerns of the fans
    [1 Fan 2 Th-B_Cu.gbl, 1 Fan 2 Th-B_Mask.gbs, 1 Fan 2 Th-B_Silkscreen.gbo, 1 Fan 2 Th-Edge_Cuts.gm1, 1 Fan 2 Th-F_Cu.gtl, 1 Fan 2 Th-F_Mask.gts, 1 Fan 2 Th-F_Silkscreen.gto, 1 Fan 2 Th-NPTH.drl]
2026-09-09 simulations & silkscreen edits
    [1 Fan 2 Th-B_Cu.gbl, 1 Fan 2 Th-B_Mask.gbs, 1 Fan 2 Th-B_Silkscreen.gbo, 1 Fan 2 Th-Edge_Cuts.gm1, 1 Fan 2 Th-F_Cu.gtl, 1 Fan 2 Th-F_Mask.gts, 1 Fan 2 Th-F_Silkscreen.gto, 1 Fan 2 Th-NPTH.drl]
2026-09-15 Getting Manufacturing Ready
    - files updated and ordered through jlcpcb
    [1 Fan 2 Th-B_Cu.gbl, 1 Fan 2 Th-B_Mask.gbs, 1 Fan 2 Th-B_Silkscreen.gbo, 1 Fan 2 Th-Edge_Cuts.gm1, 1 Fan 2 Th-F_Cu.gtl, 1 Fan 2 Th-F_Mask.gts, 1 Fan 2 Th-F_Silkscreen.gto, 1 Fan 2 Th-NPTH.drl]
2026-09-18 manufacturing & enclosure design
    [1 Fan 2 Th.kicad_pcb, 1 Fan 2 Th.kicad_sch, Base.SLDPRT, Tensility 54-00293 3-Pin Connector.SLDASM]
